duanebenson/UnoNeoClock/README.md

# UnoNeoClock
Arduino compatible NeoPixel clock design
