duanebenson/UnoNeoClock/UnoNeoClock V2.0 Bill of Materials.xlsx

Item # | Qty | Ref Des | Manufacturer | Manf part num | Distributor | Distributor Part number | Description | Package | Type
1 | 1 | U1 | Atmel | ATMEGA328P-AUR | Digikey | ATMEGA328P-AURCT-ND | MCU | 44-TQFP | SMT
2 | 1 | U2 | FTDI | FT231XS-R | Digikey | 768-1129-1-ND | USB to UART | 20-SSOP | SMT
3 | 1 | U3 | Maxim | DS3231MZ+ | Digikey | DS3231MZ+-ND | RTC | 8-SOIC | SMT
4 | 1 | Q1 | Fairchild | KDT00030TR | Digikey | KDT00030FSCT-ND | Phototransistor | 0603 | SMT
5 | 1 | Y1 | Epson | NX5032GC-16MHZ-STD-CSK-6 | Digikey | 644-1194-1-ND | 16 MHz |  | SMT
6 | 3 | D1, D2, D3 | Osram | LY R976-PS-36 | Digikey | 475-2560-1-ND | LED Yellow | 0805 | SMT
7 | 1 | D4 | Diodes, Inc | B0520LW-7-F | Digikey | B0520LW-FDICT-ND | Schottky | 0805 | SMT
 |  | D5 |  |  |  |  | TVS
8 | 2 | C1, C2 | Yageo | CC0805DRNPO9BN8R0 | Digikey | 311-1097-1-ND | 8pf | 0805 | SMT
9 | 2 | C3, C4 | Yageo | CC0805KKX7R7BB105 | Digikey | 311-1365-1-ND | 1.0uf | 0805 | SMT
10 | 1 | C5 | Yageo | CC0805KRX7R9BB103 | Digikey | 311-1136-1-ND | .01uf | 0805 | SMT
11 | 17 | C6, C7, C8, C9, C13-C25 | Samsung | CL21B104KOANNNC | Digikey | 1276-2448-1-ND | .1uf | 0805 | SMT
12 | 2 | C10, C11 | Samsung | CL21C470JBANNNC | Digikey | 1276-1156-1-ND | 47pf | 0805 | SMT
13 | 1 | C12 | AVX | F931A476MAA | Digikey | 478-8225-1-ND | 47uf |  | SMT
14 | 1 | C26 | Taiyo | LMK212BJ475KD-T | Digikey | 587-1297-1-ND | 4.7uf | 0805 | SMT
15 | 2 | L1, L2 | Bourns | MH2029-300Y | Digikey | MH2029-300YCT-ND | 30ohm ferrite | 0805 | SMT
16 | 1 | R1 | Stackpole | RMCF0805JT1M00 | Digikey | RMCF0805JT1M00CT-ND | 1M | 0805 | SMT
17 | 2 | R2, R3 | Stackpole | RMCF0805JT22R0 | Digikey | RMCF0805JT22R0CT-ND | 22 ohms | 0805 | SMT
18 | 3 | R4, R5, R6 | Stackpole | RMCF0805FT680R | Digikey | RMCF0805FT680RCT-ND | 680 ohm | 0805 | SMT
19 | 2 | R7, R8 | Rohm | MCR10ERTF2201 | Digikey | RHM2.20KCHCT-ND | 2.2K | 0805 | SMT
20 | 2 | R9, R10 | Stackpole | RMCF0805FT10K0 | Digikey | RMCF0805FT10K0CT-ND | 10K | 0805 | SMT
21 | 1 | R11 | Stackpole | RMCF0805JT4K70 | Digikey | RMCF0805JT4K70CT-ND | 4.7K | 0805 | SMT
 |  | R12 |  |  |  |  | 470 | 0805 | SMT
22 |  | S1, S2 | C&K | PTS645SM43SMTR92 LFS | Digikey | CKN9112CT-ND | Momentary push |  | DNS
23 | 2 | S3, S4 | C&K | PTS645SM43SMTR92 LFS | Digikey | CKN9112CT-ND | Momentary push |  | SMT
24 |  | J1 | FCI | 10118192-0001LF | Digikey | 609-4613-1-ND | USB microB |  | DNS
25 | 1 | J2 | FCI | 10118192-0001LF | Digikey | 609-4613-1-ND | USB microB |  | SMT
26 | 1 | B1 | Linx | BC501SM | Digikey | BC501SM-ND | 12mm Coin cell |  | SMT
27 |  | B2 | Linx | BC501SM | Digikey | BC501SM-ND | 12mm Coin cell |  | DNS
28 | 12 | LED1 - LED12 | Adafruit | 1655 | Digikey | 1528-1104-ND |  |  | SMT
29 | 4 |  | Adafruit | 1768 | Adafruit | ID: 1768 | 1/4 pixel ring |  | DNS
 |  |  |  |  |  |  |  |  | Assembly summary
 |  |  |  |  |  |  |  | BOM line items | 22
 |  |  |  |  |  |  |  | SMT | 64
 |  |  |  |  |  |  |  | BGA | 0
 |  |  |  |  |  |  |  | Thru-hole | 0
 |  |  |  |  |  |  |  | Other | 0
