duanebenson/UnoNeoClock/UnoNeoClock V2.0.brd

## EAGLE design UnoNeoClock V2.0.brd (2023-11-06)

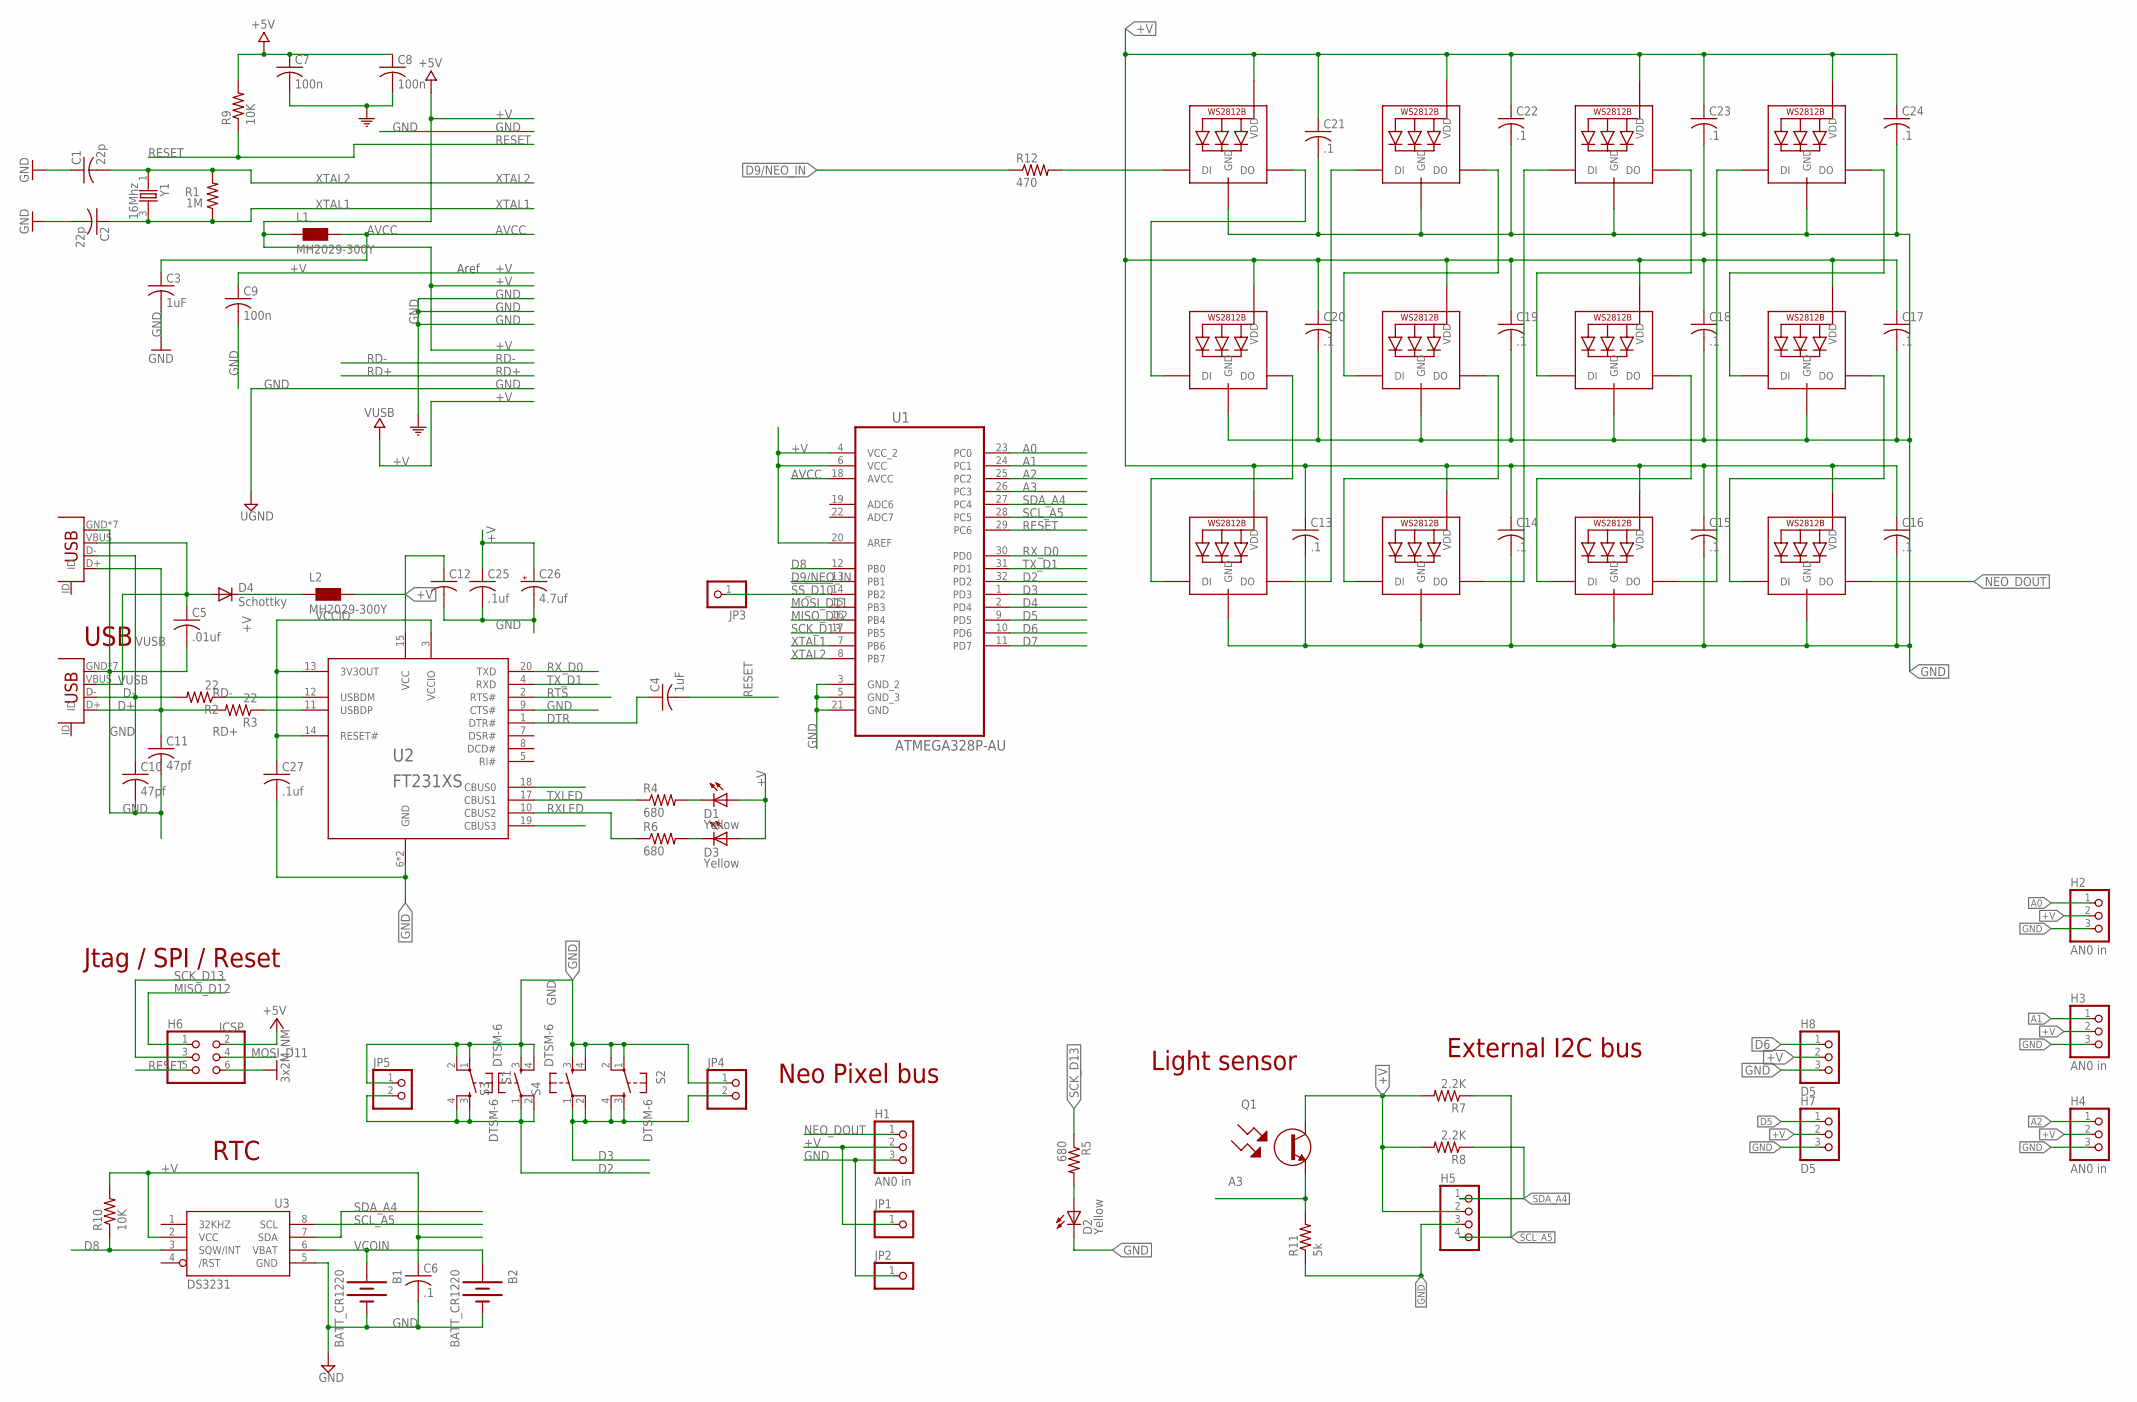
[picture p1: schematic UnoNeoClock V2.0.sch]

Parts:
B1, B2: BATT_CR1220; BATT_CR1220_HOLDER_SMT
C1, C2: 22p; C0805K
C3, C4: 1uF; C0805K
C5: .01uf; C0805K
C6, C13, C14, C15, C16, C17, C18, C19, C20, C21, C22, C23, C24: .1; C0805K
C7, C8, C9: 100n; C0805K
C10, C11: 47pf; C0805K
C12: C-USC1206K; C1206K
C25, C27: .1uf; C0805K
C26: 4.7uf; SMC_P
D1, D2, D3: Yellow; CHIP-LED0805
D4: Schottky; SOD123
H1, H2, H3, H4: AN0 in; 1X03-S
H5: PINHD-1X04_2.54-S; 1X04-S
H6: ICSP; 2X03
H7, H8: D5; 1X03-S
J1, J2: USB-MICRO-B-SMT/TH; USB-MICRO-B-SMT
JP1, JP2, JP3: PINHD-1X1; 1X01
JP4, JP5: PINHD-1X02_2.54-S; 1X02-S
L1, L2: MH2029-300Y; 0805
LED1, LED2, LED3, LED4, LED5, LED6, LED7, LED8, LED9, LED10, LED11, LED12: WS2812B5050; WS2812B
Q1: KDT00030FSTR; PT0603
R1: 1M; R0805
R2, R3: 22; R0805
R4, R5, R6: 680; R0805
R7, R8: 2.2K; R0805
R9, R10: 10K; R0805
R11: 5k; R0805
R12: 470; R0805
S1, S2, S3, S4: DTSM-6
U1: ATMEGA328P-AU; QFP80P900X900X120-32N
U2: FT231XS; SSOP20
U3: DS3231; SOIC8
Y1: 16Mhz; 3X5XTAL-SMT

Connections:
!SS_D10: JP3.1, U1.14 (PB2)
+V: C6.1, C7.1, C8.1, C9.1, C12.1, C13.1, C14.1, C15.1, C16.1, C17.1, C18.1, C19.1, C20.1, C21.1, C22.1, C23.1, C24.1, C25.1, C26.+, D1.A, D3.A, H1.2, H2.2, H3.2, H4.2, H5.2, H6.2, H7.2, H8.2, JP1.1, L1.1, L2.2, LED1.1-VDD (VDD), LED2.1-VDD (VDD), LED3.1-VDD (VDD), LED4.1-VDD (VDD), LED5.1-VDD (VDD), LED6.1-VDD (VDD), LED7.1-VDD (VDD), LED8.1-VDD (VDD), LED9.1-VDD (VDD), LED10.1-VDD (VDD), LED11.1-VDD (VDD), LED12.1-VDD (VDD), Q1.C, R7.2, R8.2, R9.2, R10.2, U1.4 (VCC_2), U1.6 (VCC), U1.20 (AREF), U2.15 (VCC), U3.2 (VCC)
A0: H2.1, U1.23 (PC0)
A1: H3.1, U1.24 (PC1)
A2: H4.1, U1.25 (PC2)
A3: Q1.E, R11.2, U1.26 (PC3)
AVCC: C3.1, L1.2, U1.18 (AVCC)
D2: JP5.2, S1.3, S1.4, S3.1, S3.2, U1.32 (PD2)
D3: JP4.2, S2.3, S2.4, S4.1, S4.2, U1.1 (PD3)
D4: U1.2 (PD4)
D5: H7.1, U1.9 (PD5)
D6: H8.1, U1.10 (PD6)
D7: U1.11 (PD7)
D8: R10.1, U1.12 (PB0), U3.3 (SQW/INT)
D9/NEO_IN: R12.1, U1.13 (PB1)
D+: C11.1, J1.D+, J2.D+, R3.2
D-: C10.1, J1.D-, J2.D-, R2.2
DTR: C4.1, U2.1 (DTR#)
GND: B1.1 (-), B2.1 (-), C1.1, C2.2, C3.2, C5.2, C6.2, C7.2, C8.2, C9.2, C10.2, C11.2, C12.2, C13.2, C14.2, C15.2, C16.2, C17.2, C18.2, C19.2, C20.2, C21.2, C22.2, C23.2, C24.2, C25.2, C26.-, C27.2, D2.C, H1.3, H2.3, H3.3, H4.3, H5.3, H6.6, H7.3, H8.3, J1.GND, J1.GND@1 (GND), J1.GND@2 (GND), J1.GND@3 (GND), J1.GND@4 (GND), J1.GND@5 (GND), J1.GND@6 (GND), J2.GND, J2.GND@1 (GND), J2.GND@2 (GND), J2.GND@3 (GND), J2.GND@4 (GND), J2.GND@5 (GND), J2.GND@6 (GND), JP2.1, JP4.1, JP5.1, LED1.3-GND (GND), LED2.3-GND (GND), LED3.3-GND (GND), LED4.3-GND (GND), LED5.3-GND (GND), LED6.3-GND (GND), LED7.3-GND (GND), LED8.3-GND (GND), LED9.3-GND (GND), LED10.3-GND (GND), LED11.3-GND (GND), LED12.3-GND (GND), R11.1, S1.1, S1.2, S2.1, S2.2, S3.3, S3.4, S4.3, S4.4, U1.3 (GND_2), U1.5 (GND_3), U1.21 (GND), U2.6 (GND), U2.9 (CTS#), U2.16 (GND), U3.5 (GND)
MISO_D12: H6.1, U1.16 (PB4)
MOSI_D11: H6.4, U1.15 (PB3)
unnamed: D2.A, R5.2
unnamed: D3.C, R6.2
unnamed: D1.C, R4.2
unnamed: LED1.2-DOUT (DO), LED2.4-DIN (DI)
unnamed: D4.C, L2.1
unnamed: LED2.2-DOUT (DO), LED3.4-DIN (DI)
unnamed: LED3.2-DOUT (DO), LED4.4-DIN (DI)
unnamed: LED4.2-DOUT (DO), LED5.4-DIN (DI)
unnamed: LED5.2-DOUT (DO), LED6.4-DIN (DI)
unnamed: LED6.2-DOUT (DO), LED7.4-DIN (DI)
unnamed: LED7.2-DOUT (DO), LED8.4-DIN (DI)
unnamed: LED8.2-DOUT (DO), LED9.4-DIN (DI)
unnamed: LED9.2-DOUT (DO), LED10.4-DIN (DI)
unnamed: LED10.2-DOUT (DO), LED11.4-DIN (DI)
unnamed: LED11.2-DOUT (DO), LED12.4-DIN (DI)
unnamed: LED1.4-DIN (DI), R12.2
NEO_DOUT: H1.1, LED12.2-DOUT (DO)
RD+: R3.1, U2.11 (USBDP)
RD-: R2.1, U2.12 (USBDM)
RESET: C4.2, H6.5, R9.1, U1.29 (PC6)
RTS: U2.2 (RTS#)
RXLED: R6.1, U2.10 (CBUS2)
RX_D0: U1.30 (PD0), U2.20 (TXD)
SCK_D13: H6.3, R5.1, U1.17 (PB5)
SCL_A5: H5.4, R7.1, U1.28 (PC5), U3.8 (SCL)
SDA_A4: H5.1, R8.1, U1.27 (PC4), U3.7 (SDA)
TXLED: R4.1, U2.17 (CBUS1)
TX_D1: U1.31 (PD1), U2.4 (RXD)
VCCIO: C27.1, U2.3 (VCCIO), U2.13 (3V3OUT), U2.14 (RESET#)
VCOIN: B1.3 (+), B2.3 (+), U3.6 (VBAT)
VUSB: C5.1, D4.A, J1.VBUS, J2.VBUS
XTAL1: C2.1, R1.1, U1.7 (PB6), Y1.3 (2)
XTAL2: C1.2, R1.2, U1.8 (PB7), Y1.1

Notes on the sheet:
USB
External I2C bus
Jtag / SPI / Reset
RTC
Neo Pixel bus
Aref
Light sensor

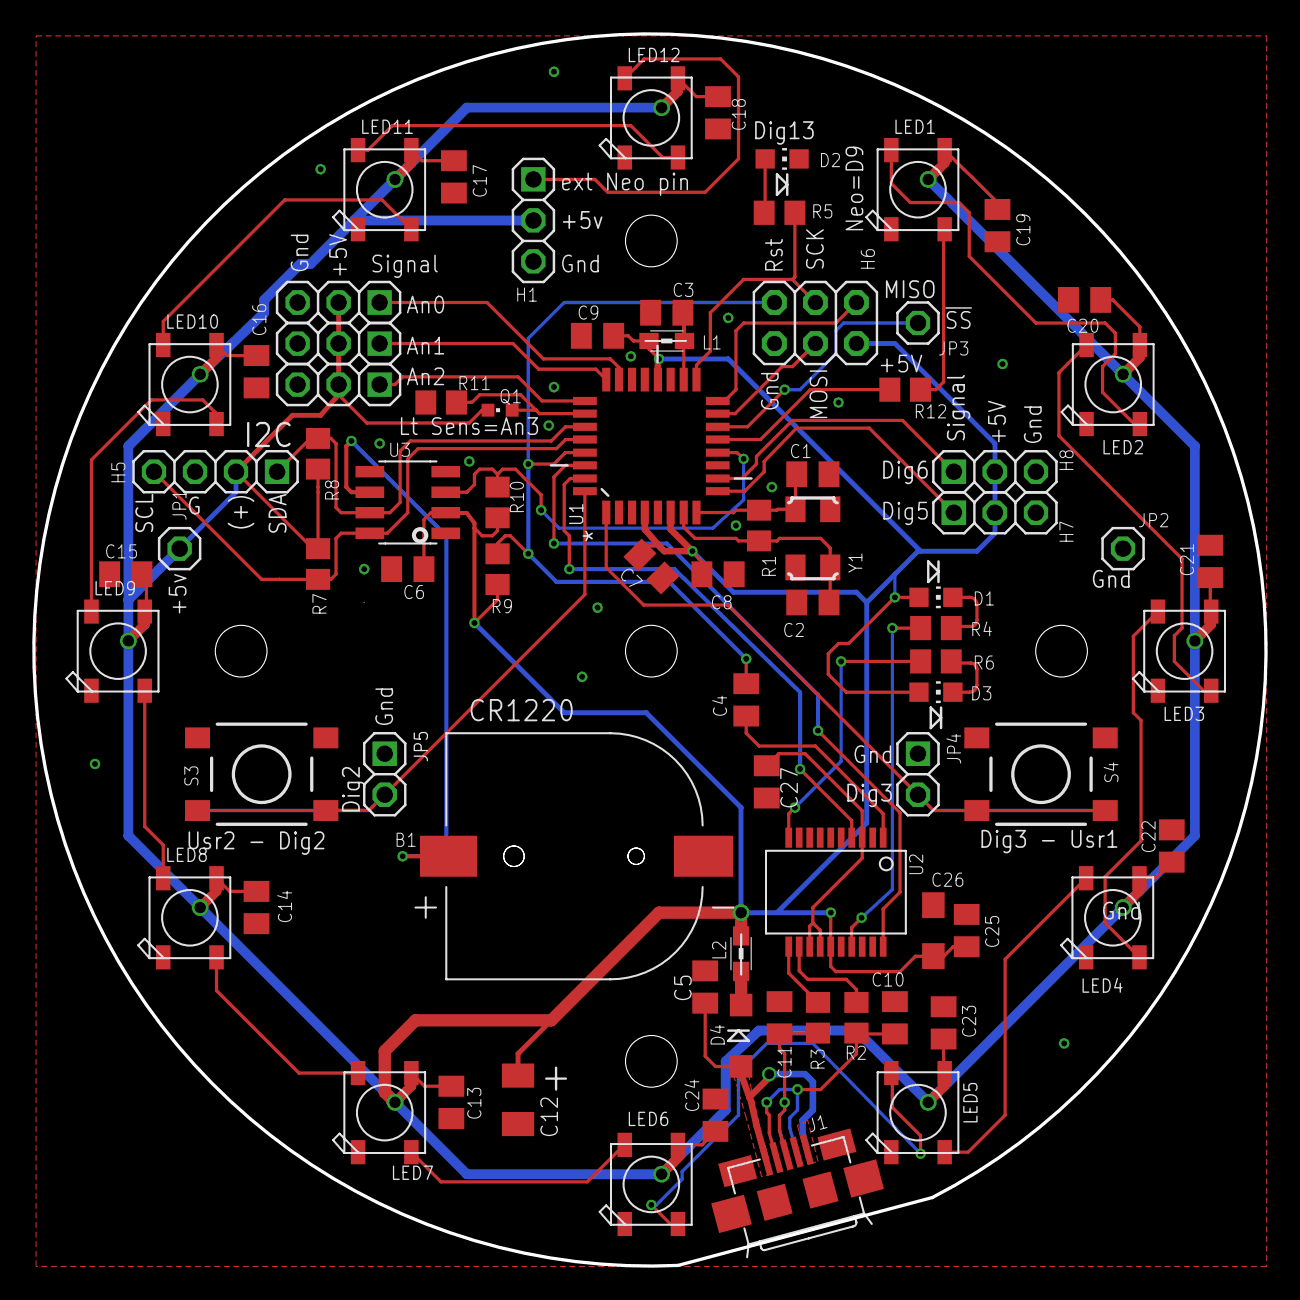
[picture p2: board UnoNeoClock V2.0.brd from above]

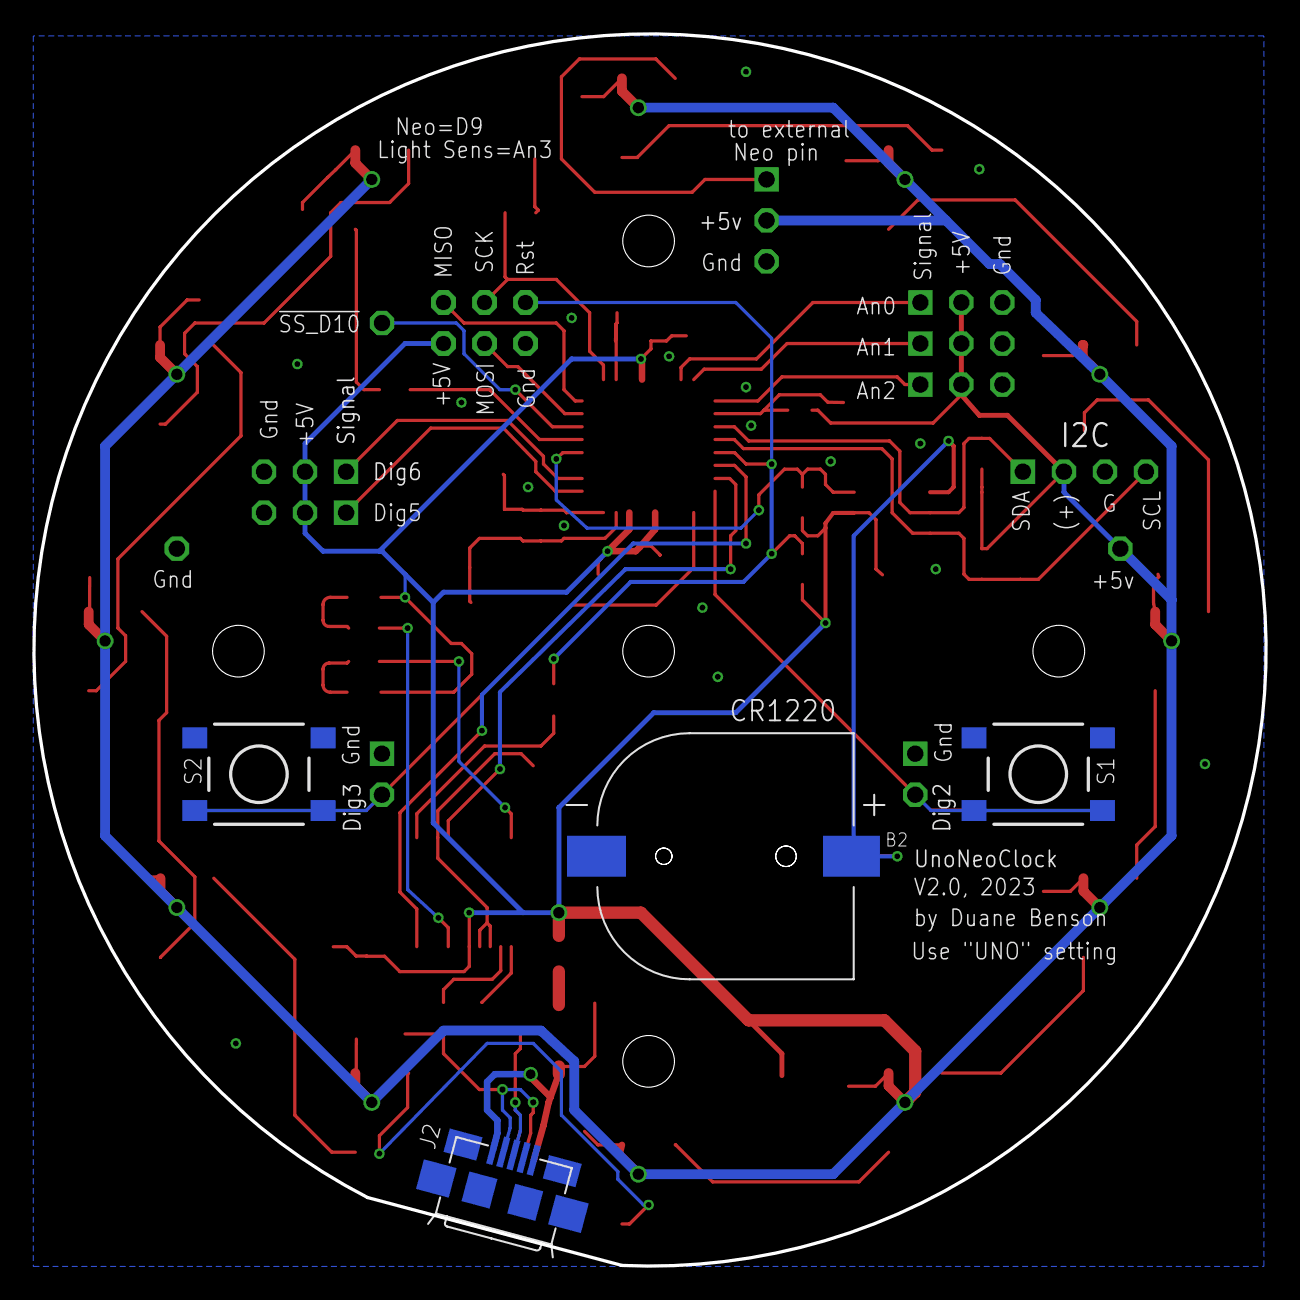
[picture p3: board UnoNeoClock V2.0.brd from below]

Board: 2 copper layers, 76.3 x 76.3 mm, 95 parts (4 on the bottom side), 51 nets.

Other parts of the board:
U$1, U$2, U$4, U$5, U$6, U$7, U$8, U$9, U$10, U$11, U$12, U$13: CLOCKPOSITION
